kaballian/IC_ABAMP/forside.tex

\begin{center}
    \begin{figure}
        \centering
        
        \label{fig:logo}
    \end{figure}

\vspace*{1cm}
\huge  
\textbf{\hrulefill \\ EIC \\ \hrulefill}
\Large
\textbf{\\ Integrerede kredsløb}
\vspace{0.5cm}

\LARGE
%\textbf{Aarhus Universitet\\}
\vspace{0.7cm}
\resizebox{17cm}{!}{
\begin{tabular}{lllc}
     \multicolumn{4}{c}{IC Project - class AB Amplifier}\\
     \\
     \textbf{Navn} & \textbf{Initialer} & \textbf{Studienummer} & \textbf{Retning}\\
     \toprule
        Jakob Bjerregaard Olsen& JBO & 202109022 & E\\
        Alexander Nygaard Thomsen & AT & 201911329 & E\\

    \toprule
\textbf{Underviser: Jamaac Hassan Hire}  \\
\toprule
\\
    Afleveringsdato: 28/12/2025 \\
\end{tabular}
}
\end{center}
\newpage
