kaballian/IC_ABAMP/assignment_projectAB.pdf

# EIC

## Integrerede kredsløb

## IC Project - class AB Amplifier

Navn | Initialer Studienummer Retning
Jakob Bjerregaard Olsen | JBO | 202109022 | E
Alexander Nygaard Thomsen | AT | 201911329 | E

## Underviser: Jamaac Hassan Hire

## Afleveringsdato: 28/12/2025

## 1 introduction

The purpose of this project is to design and implement a Class AB audio power Amplifier, with some general requirements.
From the provided requirements of the project, the below states specifications are:
| Output power - This specification is a free choice and will be expanded later
| Input Resistance - >= 10kΩ
| Output Resistance - < 5Ω
| Bandwidth - bandwidth is specified to be in the human hearing range 20Hz - 20KHz
| Design Structure - must be based on a three stage topology, differential pre-amp, voltage amp stage and power amp stage.

From these given, overall requirements, our derived specifications are:

| Output power - Pout = 200mW
| load size - Giver the output power, the chosen load size is Rload = 16Ω
| Supply contrains - given power requirements and load size, the supply rails of the Amplifier system is ±15V

From our on own requirements, it is possible to derive some other specifications about the system. The output voltage/current RMS

VoutRMS =

p
Pout · Rload | (1)

IoutRMS =

r
Pout

Rload

(2)

We assume an input signal of VinRMS = 20mV , this gives an overall gain of

Vout

Vin

≈ 126 | (3)

To limit the Amplifier to the human hearing range, an lowpass filter is added to limit frequency content above 20KHz

fC = 20KHz | (4)
C = 470µF | (5)

XC =

1
2πf · C
= 0.017Ω | (6)

## 2 Input stage

The first part of the amplifier is the input stage, this specific implementation is build around a pair of NPN transistors. This particular implementation includes a tail current source, more specifcally a current mirror build as a sink.

### 2.1 topology

### 2.1.1 differential pair

Q4 and Q5 is an NPN differential pair, with R3 and R2 as collector loads and R15 and R16 as emitter degeneration resistors. This create a single-ended output differential amplifier. The emitter resistances are included to negate the temperature dependence of BJT’s and to make the transistor have a more linear behavior. This however changes how the transistors transconductance is calculated from gm =

IC
VT

to gm ≈

1
RE

, if and only if gmRE ≫ 1.

DC analysis


It is assumed that the BC547 has an beta factor of β = 325 and we aim for a diff amp gain of roughly Adif f ≈ 42. The current sink in bottom tries to draw 4mA of current, thus IEcm = 2mA must run in each branch of the Amplifier. The collector resistance then becomes

VCcm = VCC − RCcm · IEcmα ⇒ RCcm =

VCC − VCcm

IEcmα

= 7.774kΩ | (7)

AC analysis
For AC analysis, the intrinsic emitter resistance is re =

VT
2mA = 12.5Ω and the external emitter resistance is RE = 75Ω this yields a total emitter resistance of retot = 12.5Ω + 75Ω = 87.5Ω. Thus changes to temperature only affects the term with VT , which is ≈ ±2mV /C
The goal here is to relate the differential input voltage Vd to the output voltage Vo, by elimintating the internal transistor current ib, this will yield the gain. Since the desired gain for this Amplifier is chosen, we can use this to find the emitter resistance, which stated earlier is RE = 75Ω.

Since the other input of the differential amplifier is grounded, the differential voltage for Q4 becomes:

vIndif f
2
= ibrπ + ieRE | (8)
rπ = βre | (9)
ie = (β + 1)ib | (10)
⇓ | (11)
vd = 2ib(βre + (β + 1)RE) | (12)

And the common mode voltage then becomes:

vOutdif f = −β · ibcm · RCcm | (13)

These two defines the differential gain:

Adif f =

vOutdif f vIndif f
= −
βRC 2(βre + (β + 1)RE) | (14)

Since the gain has already been chosen in the design stage, as mentioned ealier, Adif f ≈ 42. The emitter resistance can be calculated, by solving for RE:

Adif f → RE ≈ 75Ω | (15)

It should be noted that the expression for the differential gain gets rather lengthy when expanded, thus for gains much larger than β ≫ 1, the 1 term in (β + 1), can safely be ignored. This factors out β in both numerator and denominator:

2(βre + (β + 1)RE) ⇒≈ β(re + RE) | (16)

Adif f ≈ −

RC
2(re + RE)
≈ −42.726 | (17)

It is desirable to know the common mode rejections ratio, and in order to find that, the common mode gain is needed. The common mode gain is given by the common mode input voltage over the common mode output voltage. But in order to express them the value of REE needs to be known. REE is placed to reduce the stress on the transistor in the current mirror. An assumption of the collector emitter voltage being 0.3V is made to ensure that the transistor is operating in the active region. Based on this assumsion the expression for REE is given by

0V − VBE − RE · IE − 2 · IE · REE − VCE − VEE = 0V | (18)

REE =

VBE − RE · IE − VCE − VEE
2 · IE
= 3.838kΩ ≈ 3.9kΩ | (19)

Now the common mode input voltage can be expressed as:

vInCM = ib · (β + 1) · re + ib · (β + 1) · RE + 2 · ib · (β + 1) · REE | (20)

The times 2 comes from the fact that know there is a contribution from both branches. The output common mode is given by:

vOutCM = −β · ib · RC | (21)

With the two above equations the common mode gain can be expressed as:

ACM =

vOutCM

vInCM

=

−β · ib · RC
ib · (β + 1) · re + ib · (β + 1) · RE + 2 · ib · (β + 1) | (22)

In the above equation ib can be removed because it is multiplied on both the denominator and numerator. Then by combining common expressions in the denominator then the gain can be expressed as:

ACM =

−β · ib · RC
(β + 1) · (re + RE + 2 · REE)
= −0.948 | (23)

Now that both the differential and common mode gain is known the common mode rejection ration can be calculated. It is given as:

CMRR = 20 · log(Adif f
ACM
) = 33.078dB | (24)

### 2.2 Current Sink

The pupose of the current mirror is to supply, or in this case ”sink” the required current for the differential amplifier. This means that it should be specified to draw the sum of the currents leaving both branches of the diff amp. Thus the equations becomes:

ICQ6 = IEEcm = 4mA | (25)
(26)

Because it is a BC547 again, the same β = 325 is assumed, this means that current entering the base of Q6.

IBQ6 =

ICQ6
β
≈ 12µA | (27)

(28)

Since the current mirror is comprised to two NPN transistors, the current drawn should be the sum of the collector current ICQ5 and 2 base currents.

IRCQ5 = 2IBQ6 + ICQ5 = 4.025mA | (29)

Therefore the resistance to define the reference current becomes:

Rref =

VCC − VEE

IRCQ5

≈ 7.5kΩ | (30)

## 3 Voltage Amplification Stage

Following the differential amplifier is a Voltage amplification stage. The purpose of this circuit is to gain the signal.


Figure 1: voltage amplification stage

The design goal of this stage is a gain of 3. And to realize this goal a few other contraints are chosen to make it easier, such as the emitter current should be IE = 5mA and VCE = 7.5V , to ensure in the active region.

From these contrains the ratio of the emitter and collector resistor can be determined. Also note that this the current design is for DC, thus for the AC gain an additional impedance can be coupled in to reduce the emitter resistance in AC and increase the gain.

iB =

vin

RIN

vo = −RC ibβ | (31)

subtituting

vo = −RC

vin

RIN

β ⇒ −α

RC
RE

(32)

Setting RC = 3kΩ, means that, at AC, RE = 1kΩ
To achieve the current at DC, the emitter resistance can be calculated:

REdc =

VCC − RC IEα − V CE − VEE
IE
≈ 1.5kΩ | (33)

To compensate for this in AC, an impedance consisting of a resistance and a capacitor is set in parallel with the emitter resistance. This essentially shapes the gain when an AC input is given.

ANdc =

R8
R9
= 2 | (34)

ANac =

R8
R9||R28
| = 3 | (35)

This happends when when the corner frequency of:

fc =

1
2πR28C6

=

1
2π · 3kΩ · 47nF
| ≈ 1.13Hz | (36)

is exceeded.
Other parameters for the stage:
VC = VCC − RC IEα = 0.046V | (37)
VE = IERE + VEE = −7.5V | (38)
VB = VE + VBE = −6.8V | (39)

IB =

IE
(β + 1) ≈ 15.3µA | (40)

Biasing the stage then comes from a collector base resistor

RC B =

15V − (−6.8V )
15.3µA | = 1.425MΩ | (41)

## 4 Unity gain Buffer

To prevent loading of the voltage amplification stage into the output stage, a unity gain buffer is implemented to increase the perceived impedance, the output of the voltage amplification stage sees. This is implemented as a common collector amplifier with a gain of ≈ 1.

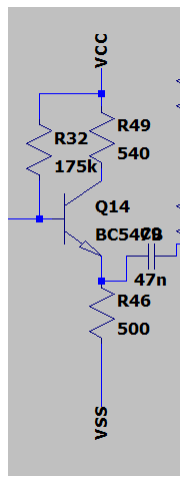
[picture p10: figure]

Figure 2: common collector unity gain buffer

To ensure that the buffer has low output impedance, so it does not affect the circuitry that comes after, a decently sized standing current is necessary. To drive the stage a ratherl large emitter current of 28mA is chosen.

VE = VSS + IER46 = −1V | (42)
VB = VB + 0.7V = −0.3V | (43)

IB =

IE
β + 1
≈ 85µA | (44)

The biasing resistor then becomes:

R32 =

VSS − VB
IB
≈ 178kΩ | (45)

The collector current then becomes:

IC =

β
β + 1
IE ≈ 27.9mA | (46)

and to sanity check if the current is possible the voltage across the collector and emitter must be above 0.3V

VC = V cc − IC R49 = −0.074V | (47)
VCE = VC − VE = 0.926V | (48)

This shows that the unity gain buffer can drive this configuration. The small signal parameters becomes:

re ≈

VT
IE

=

25mV
28mA = 0.893Ω | (49)
rπ = βre ≈ 290Ω | (50)

Output impedance, when looking into the emitter. The sources becomes AC ground, this means that the output impedance becomes

Rout ≈ re||500Ω ≈ re | (51)

## 5 Output Stage

The output stage consists mainly of circuitry to handle the final power amplification of the amplification, the purpose is to gain the currents and not the voltage signal. Because this is a Class AB, this means that two output transistors are driving each half of the signal cycle, however to change this from class B to AB, it requires transistor biasing, so that cross distortion is avoided.


Figure 3: Output stage, everything to the right of the red line, is considered part of the output stage.

To bias the two output transistors, a Vbe multiplier has been implemented. Q15 and the two resistors R37/38 generate a controlled voltage, which is used to determine the working point of the output follow the expression:

Vbias ≈ VbeQ15 · (1 + R37
R38
) ≈ 2VBE | (52)

This then becomes a scale factor for the transistors base emitter voltage, meaning that the collector voltage will sit an additional drop above it, of ≈ 1.4V Practically this circuit also provides the ability to thermally track or follow the output transistors, due the possibility to physically mount the circuit thermally close to the output.

The biasing part of the stage is driven by a current sink similar to the one found in the input stage, however this sinks 3mA of current. This means that the voltages at the output stages are.

VR47 = 3mA · 4.8kΩ = 14.4V | (53)
VBm3 = 0.6V | (54)
VR42 = 3mA · 4.5kΩ = 13.5V | (55)
VBm4 = −15V + 13.5V = −1.5V | (56)

Quiescent current through the output stage can then be expressed as:

IQ ≈

Vbias − (VBE,N + |VBE,P |)
R43 + R44

(57)

This indicates that the output stage is somewhat sensitive to changes in changes in both transistors Vbe due to fact that those resistances, R43 + R44 are so small.

The two emitter resistors linearize the transfer characteritics of the output transistors and limits thermal runaway. The main purpose of those transistors, is to turn small changes in Vbe into current chnages, therefore the small signal voltage gain is AN ≈ 1. The output impedance, can be approximated by

Rout ≈

re
β + 1
+ R43 + R44 | (58)

Where re ≈

VT
IE

### 5.1 Simulation

Using the calculated values from the analysis, the circuit was then simulated in LTspice. The complete circuit can be seen below. Using the .tren spice directive to test the circuit and checking for behavior.


Figure 4: Complete circuit in LTspice.

Grounding both of the inputs and probing the simulation model, resulted in a measurement of 1.468V at the collector of Q4 and having its emitter sit a diode drop below ground, means that this transistor is in the active region.

At Dc the current sink through R27 is around 3.6mA.

As for the voltage amplification stage, the collector sits at 0.56V and the emitter at -7.76V, this means that this coupling also is in the active region. With an emitter current of roughly 4.8mA

In the output stage, the current drawn thought the vbe multiplier is roughly 2.94mA, which is close to the desired 3mA. The lower bias point sits at ≈ −474mV , while the upper bias point is at ≈ 842mV , this means that there is approximately a multiple of 2 base emitter voltage difference between the two points, which is intended.

Lastly the Quiescent current, at DC, running through R42 is 1.92mA. This current is flowing to load, as it seems to be strongly tied to ground. There is only 30mV at the collector of M4, so the Vbe of M4 is not high enough to draw the current at this stage.


Figure 5: RMS current measurement at the output of the amplification, more specifically the current running in the load

With a RMS current of IOUT = 95.832mA running in the 16Ω load, the power can be calculated:

VOUT = IRMS · RLOAD = 95.832mA · 16Ω = 1.5328VRMS | (59)
POUT = IRMS · VOUT = 0.146W | (60)

This simulated power is a little lower than intended.

### 5.2 Realization

The circuit was the built and realized. The realized circuit can be seen on figure 6. The circuit was tested the same way the simulation was, the settinges for the signal used can be seen on figure 7

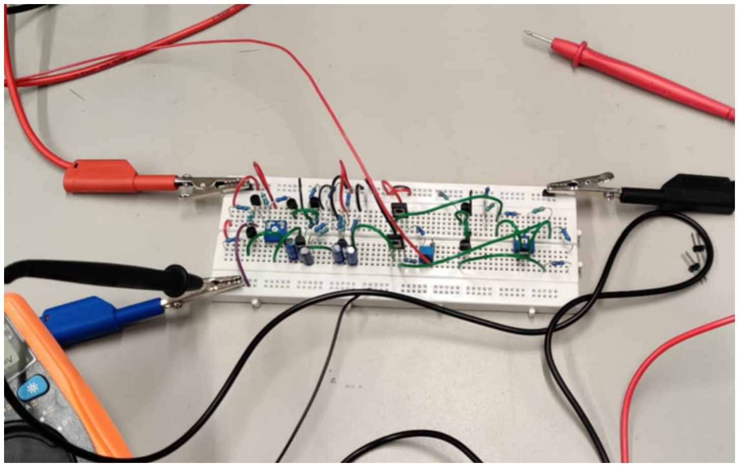
[picture p11: figure]

Figure 6: implementation on breadboard


Figure 7: The chosen input signal is a pure signe wave with a 20mV amplitude at 10kHz

Table 1: Measured DC voltages of bias points in amplifier circuit

Class AB DC points | Diff sig[V] | Diff No sig[V] | CE amp[V] | C amp[V] | AB NPN[V] | AB NPN[V]
V C | 1.83 | 2.18 | -0.15 | 0.88 | 15 | -15.01
V E | -0.644 | -0.645 | -6.75 | -0.82 | -0.76 | -0.28
V B | 0 | 0 | -5.6 | -0.16 | 0.44 | -1.02

On figure 8 the amplification results can be seen for after the common mode amplifier and the commen emitter amplifer(voltage amplification stage). The final gain for the amplifier is somewhat lower than expected. On table 1 the DC point for the diffrent transistors is shown, here it can be seen that the DC points are the with in resenable range and they are in the active region


Figure 8: Measurements of the amplifier. The orange trace is from after the differential amplifier, to show much the signal is gained. The blue trace is from the output of the amplifier itself.

## 6 conclusion

It can then be concluded that the audio amplifier works as intended and that it mostly satisfies our requirements, set in the specification. However, we fell short of the gain goal of ≈= 126, we achieved ≈ 87, the measured signal peak of the output was

VoutP eak = 1.749V | (61)

VoutRMS =

1.749V
√
2
= 1.236VRMS | (62)

Whereas the input rms is roughly VinRMS = 0.014V this leads to a input to output ratio of

Vout

Vin

=

1.236V
0.014
≈ 87.45 | (63)

As for power, the output current becomes 1.236
16Ω = 77.25mARMS which results in 1.749V · 77.25mA = 95.53mW of power being drawn, this is also not close our target of 200.
