kaballian/IC_ABAMP/Class AB AMP.pdf

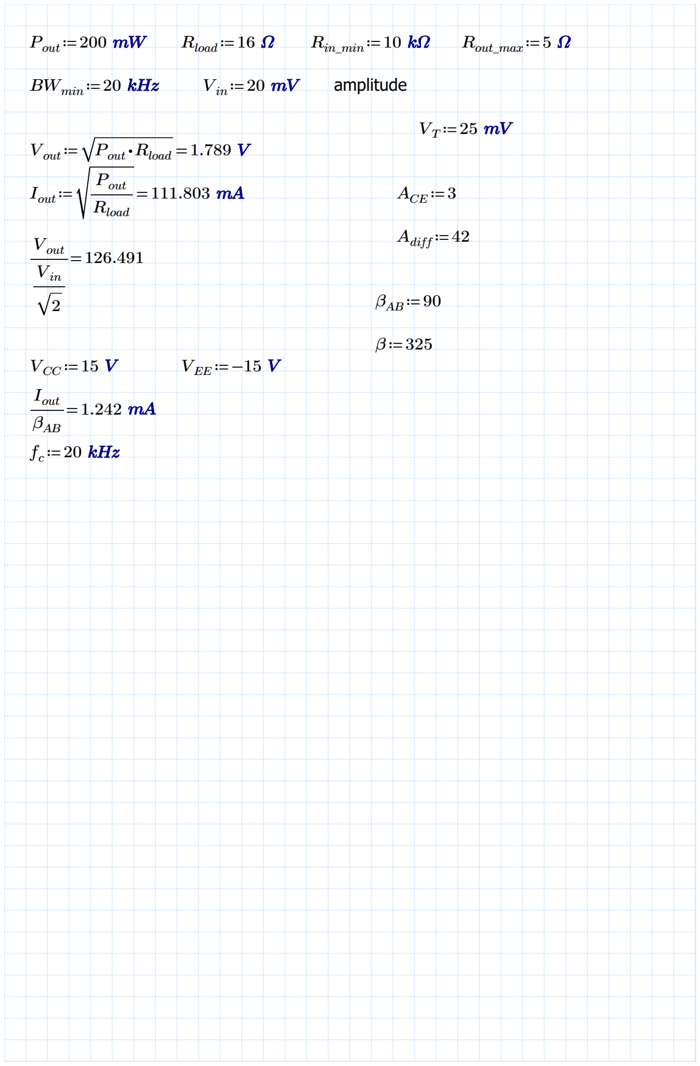
[picture p12: figure]
Pout≔200; Rload≔16 Ω; Rin_min≔10 kΩ; Rout_max≔5 Ω; BWmin≔20 kHz; Vin≔20; amplitude; Vout≔; Pout⋅Rload=1.789 V; Iout≔; Pout; Rload; ACE≔3; Adiff≔42 ――= Vout; Vin; βAB≔90; VCC≔15 V; VEE≔-15; Iout; βAB; fc≔20 kHz

Non-Commercial Use Only

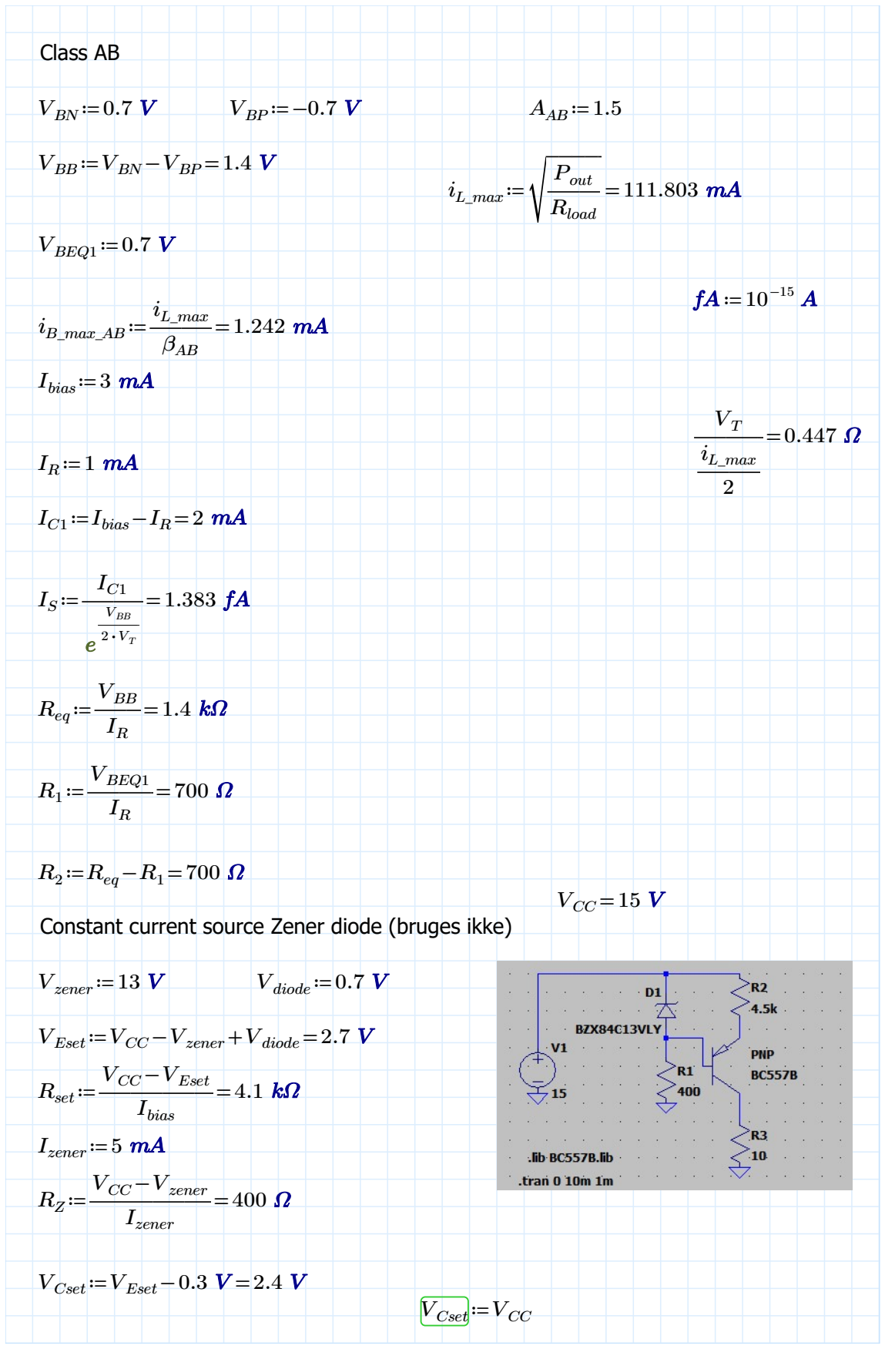
[picture p13: figure]
Class AB; VBN≔0.7 V; VBP≔-0.7 V; AAB≔1.5; VBB≔VBN -VBP=1.4; iL_max≔; Pout; Rload; VBEQ1≔0.7 V; iB_max_AB≔――=; iL_max; βAB; Ibias≔3; iL_max 2; IC1≔Ibias-IR =2 mA; VBB 2 ⋅ VT; Req≔――=; VBB IR; VBEQ1 IR; R2≔Req-R1=700; VCC =15 V; Vzener≔13; Vdiode≔0.7 V; VEset≔VCC -Vzener+Vdiode=2.7 V; Rset≔――――=; VCC -VEset; Ibias; Izener≔5 mA; VCC -Vzener; Izener; VCset≔VEset-0.3 V =2.4 V; VCset≔VCC

Constant current source Zener diode (bruges ikke)

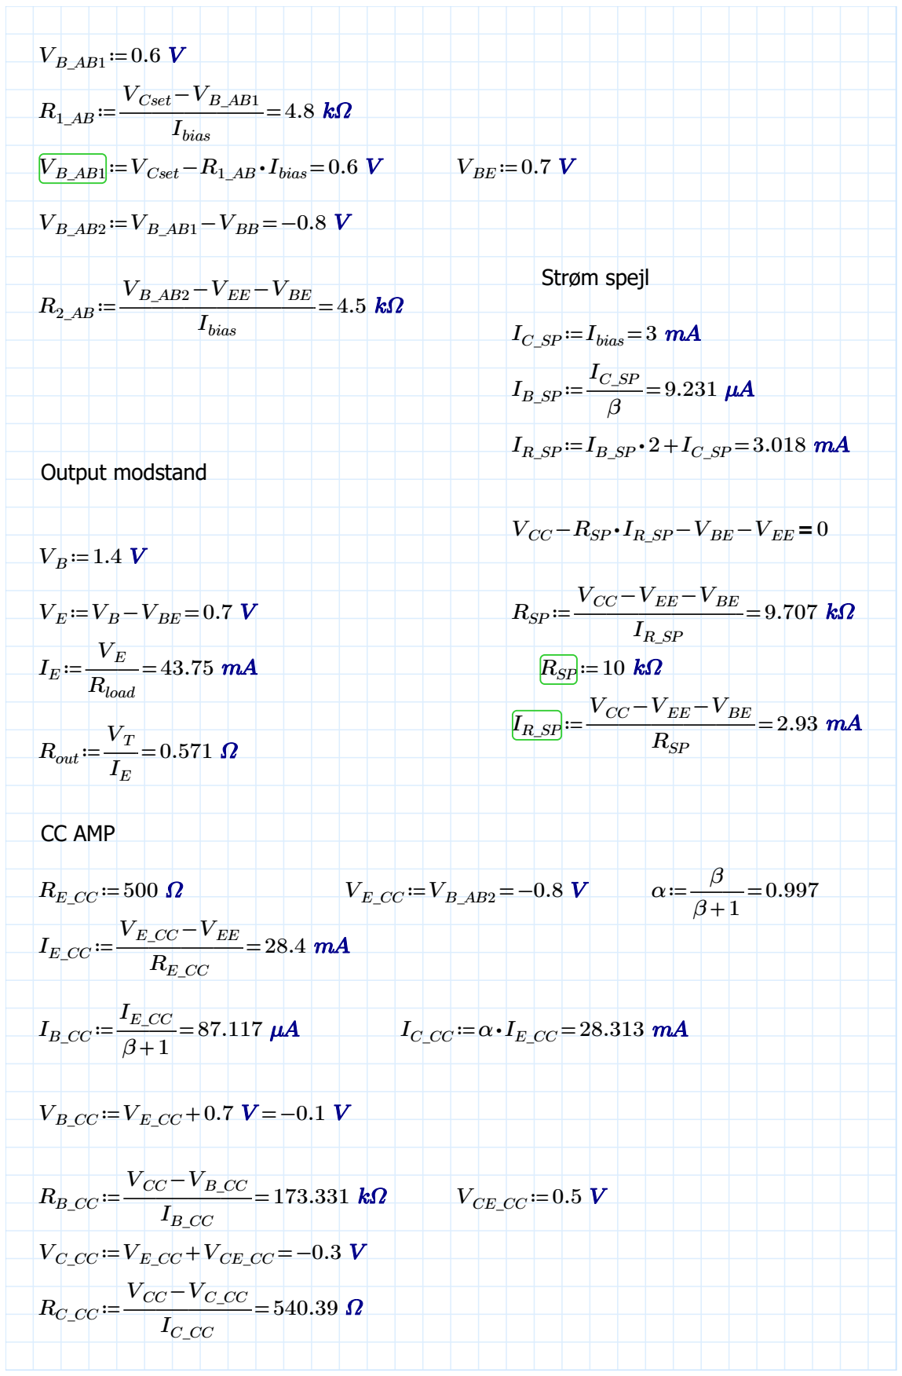
[picture p14: figure]
VCset-VB_AB1; Ibias; VB_AB1≔VCset-R1_AB ⋅ Ibias=0.6; VBE≔0.7 V; VB_AB2≔VB_AB1-VBB =-0.8 V; Strøm spejl; VB_AB2-VEE -VBE; Output modstand; IC_SP≔Ibias=3 mA; VE≔VB -VBE =0.7 V; Rload; VCC -RSP ⋅ IR_SP-VBE -VEE＝0; Rout≔――=; RSP≔――――――=; VCC -VEE -VBE; RSP≔10 kΩ; RSP; CC AMP; VE_CC -VEE; VCC -VB_CC; VCE_CC≔0.5; VC_CC≔VE_CC +VCE_CC =-0.3 V; VCC -VC_CC

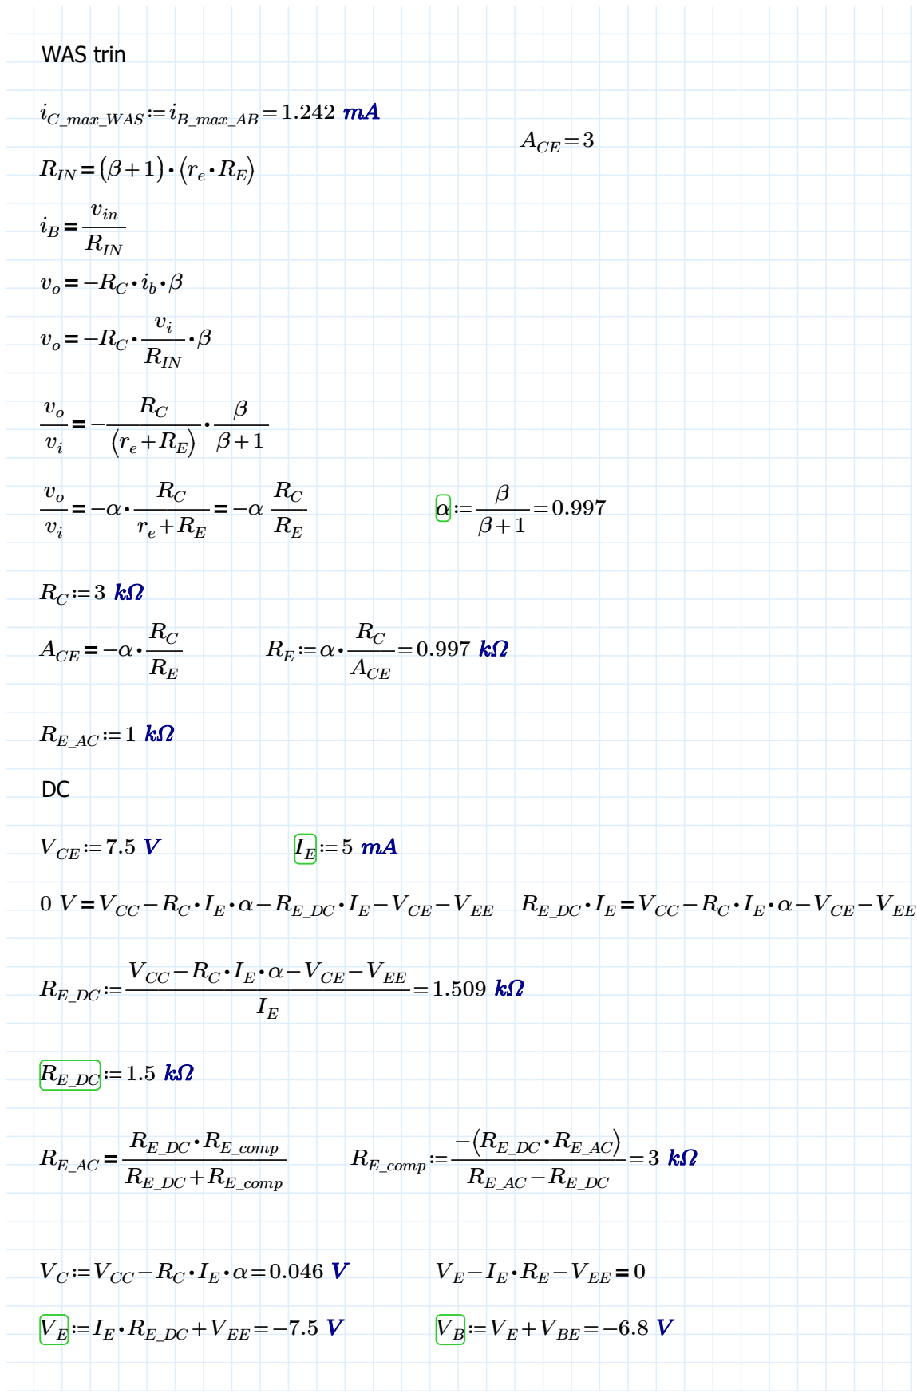
[picture p15: figure]
WAS trin; iC_max_WAS≔iB_max_AB =1.242 mA; ACE =3; RIN＝((β+1)) ⋅ ⎛⎝r; vin; RIN; ACE＝-α⋅――; ACE; VCE≔7.5 V; VCC -RC ⋅ IE ⋅α-VCE -VEE IE; RE_DC ⋅RE_comp; RE_DC +RE_comp; RE_comp≔――――――=; VE≔IE ⋅RE_DC +VEE =-7.5; VB≔VE +VBE =-6.8

0 | V＝VCC -RC ⋅ IE ⋅α-RE_DC ⋅ IE -VCE -VEE | RE_DC ⋅ IE＝VCC -RC ⋅ IE ⋅α-VCE -VEE
VC≔VCC -RC ⋅ IE ⋅α=0.046 V | VE -IE ⋅RE -VEE＝0

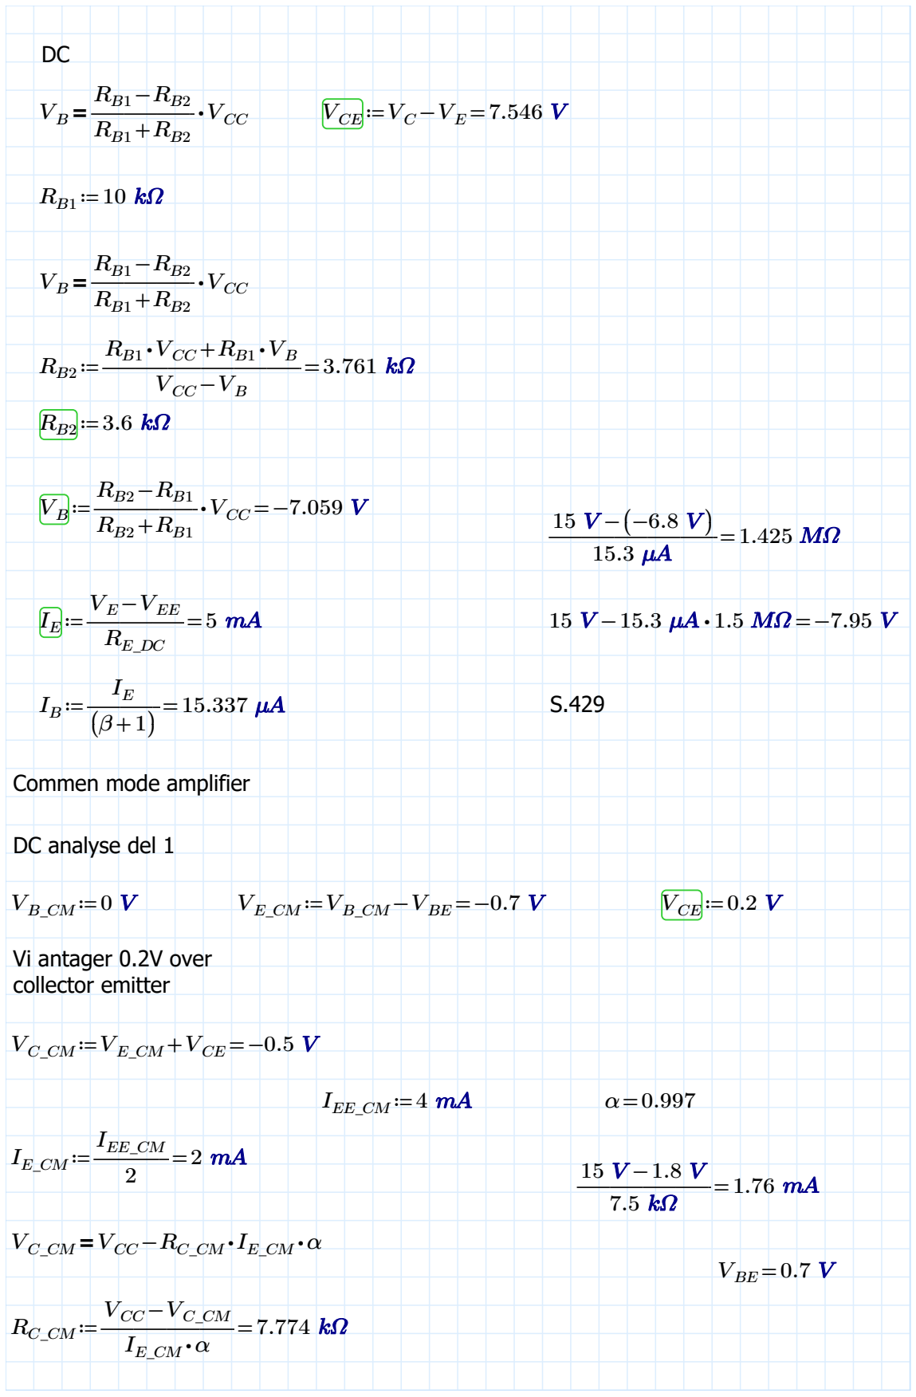
[picture p16: figure]
VCC; VCE≔VC -VE =7.546; RB1 ⋅VCC +RB1 ⋅VB VCC -VB; VE -VEE; Commen mode amplifier; DC analyse del 1; VE_CM ≔VB_CM -VBE =-0.7 V; VCE≔0.2 V; Vi antager 0.2V over collector emitter; VC_CM ≔VE_CM +VCE =-0.5 V; IEE_CM ≔4; IEE_CM 2; VC_CM＝VCC -RC_CM ⋅ IE_CM ⋅α; VBE =0.7 V; VCC -VC_CM

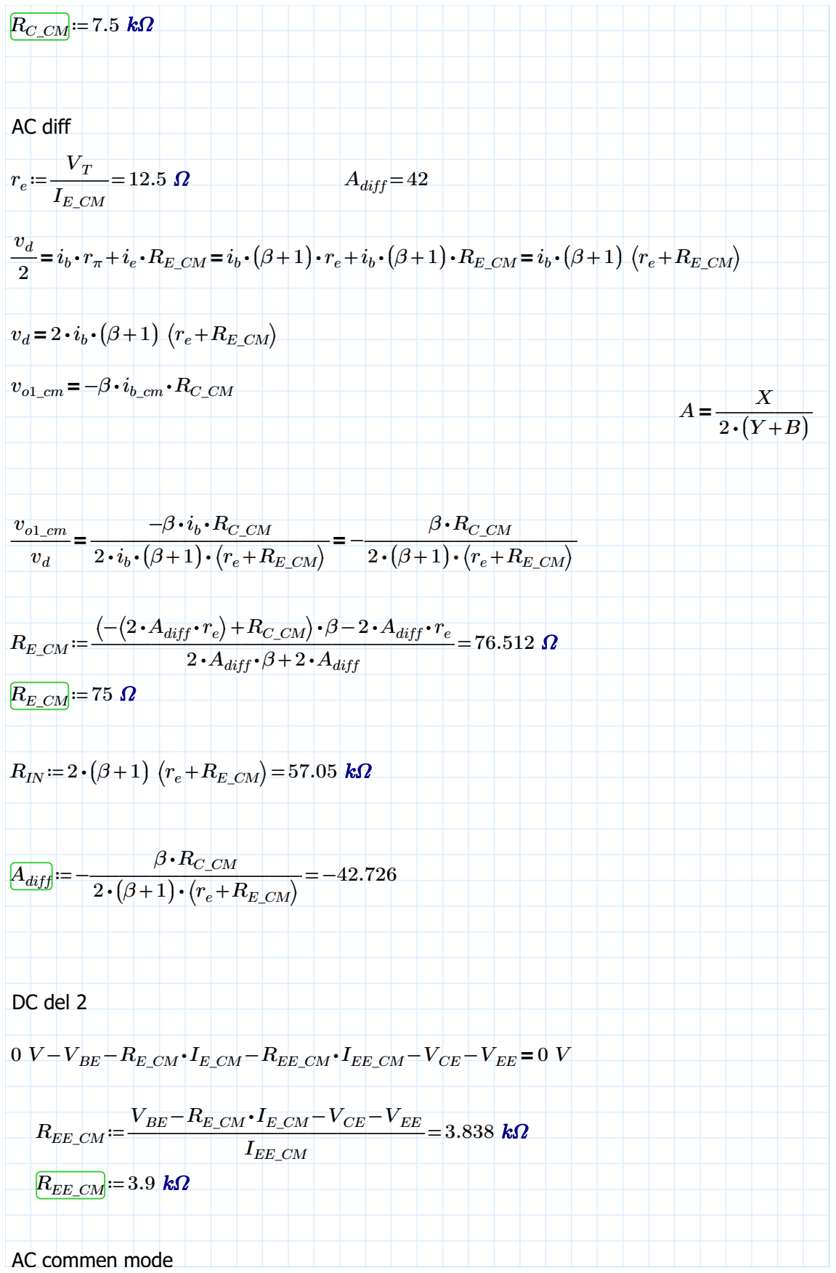
[picture p17: figure]
AC diff; Adiff=42; ⎛⎝-⎛⎝2 ⋅Adiff ⋅ re; ⋅ diff re; 2 ⋅Adiff ⋅β+2 ⋅Adiff; RIN≔2 ⋅ ((β+1)) ⎛⎝re+RE_CM⎞; Adiff≔-――――――――=; DC del 2; REE_CM ≔――――――――――=; VBE -RE_CM ⋅ IE_CM -VCE -VEE; IEE_CM; REE_CM ≔3.9; AC commen mode

### 0 V-VBE -RE_CM ⋅ IE_CM -REE_CM ⋅ IEE_CM -VCE -VEE＝0 V

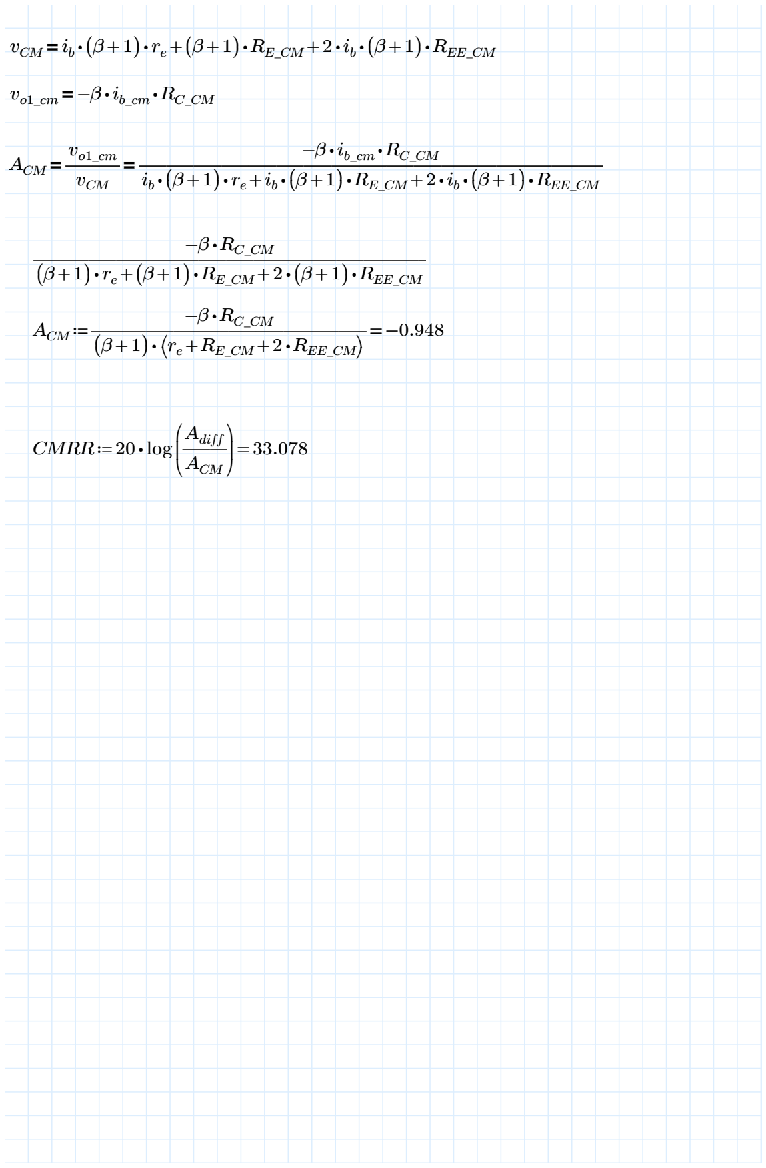
[picture p18: figure]
vCM＝ib; REE_CM; ACM＝――＝; vCM; ACM ≔―――――――――――=; -β⋅RC_CM ((β+1)) ⋅ ⎛⎝re+RE_CM +2 ⋅REE_CM⎞ ⎠; CMRR≔20 ⋅log; Adiff; ACM

⋅ ((β+1)) ⋅ re+((β+1)) ⋅RE_CM +2 ⋅i | ⋅ | ⋅ b

((β+1)) ⋅ re+((β+1)) ⋅RE_CM +2 ⋅ ((β+1)) ⋅REE_CM

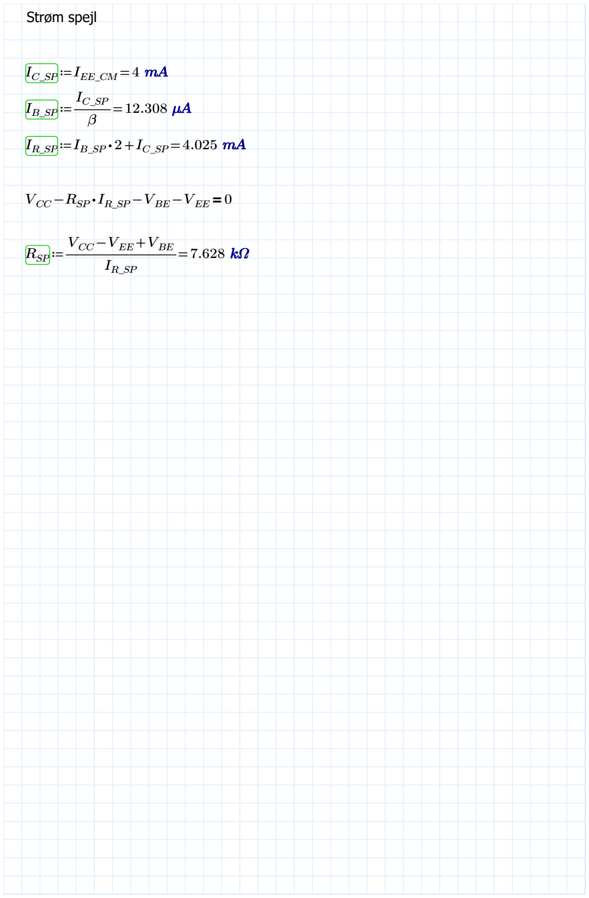
[picture p19: figure]
Strøm spejl; IC_SP≔IEE_CM =4 mA; VCC -RSP ⋅ IR_SP-VBE -VEE＝0; RSP≔――――――=; VCC -VEE +VBE
