kaballian/IC_ABAMP/power_amp.png

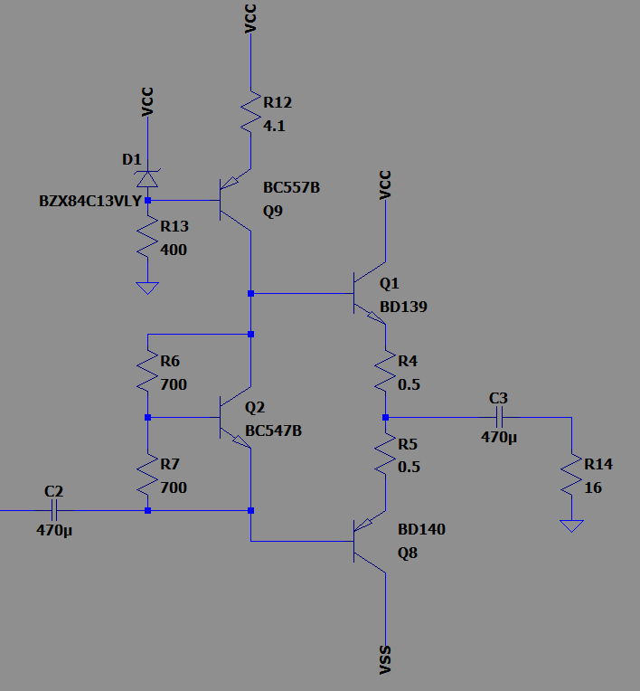
power_amp.png
