kaballian/IC_ABAMP/zener_source.png

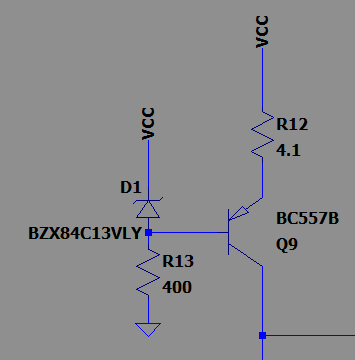
zener_source.png
