kaballian/IC_ABAMP/measurements/AB amp.ods

Class AB DC points | Diff Sig [V] | Diff No sig | CE Amp | CC Amp | AB NPN | AB PNP
V_C | 1,83 | 2,18 | -0,15 | 0,88 | 15 | -15,01
V_E | -0,644 | -0,645 | -6,75 | -0,82 | -0,76 | -0,28
V_B | 0 | 0 | -5,6 | -0,16 | 0,44 | -1,02
