kaballian/IC_ABAMP/AudioAmp.asc

C1: cap; 47n
C2: cap; 47n
C3: cap; 47µ
C4: cap; 47µ
C5: cap; 47µ
C6: cap; 47n
C7: cap; 47µ
C9: cap; 47n
D1: zener; BZX84C13VLY
D2: diode; 1N4148
D3: diode; 1N4148
D4: zener; BZX84C13VLY
D5: zener; BZX84C13VLY
L3: ind; 1m
L4: ind; 1m
M1: nmos; BD139
M2: pmos; BD140
M3: nmos; BD139
M4: pmos; BD140
Q1: npn; BC547B
Q2: npn; BC547B
Q3: npn; BC547B
Q4: npn; BC547B
Q5: npn; BC547B
Q6: npn; BC547B
Q7: npn; BC547B
Q8: npn; BC547B
Q9: pnp; BC557B
Q10: npn; BC547B
Q11: npn; BC547B
Q12: npn; BC547B
Q13: pnp; BC557B
Q14: npn; BC547B
Q15: npn; BC547B
Q16: pnp; BC557B
Q17: npn; BC547B
Q18: npn; BC547B
R1: res; 7.5k
R2: res; 7.5K
R3: res; 7.5K
R4: res; 1
R5: res; 1
R6: res; 650
R7: res; 650
R8: res; 3k
R9: res; 1.5k
R10: res; 1.425Meg
R11: res; 4.7Meg
R12: res; 4.1k
R13: res; 390
R14: res; 16
R15: res; 75
R16: res; 75
R17: res; 7.628k
R18: res; 7.5k
R19: res; 7.5k
R20: res; 75
R21: res; 75
R22: res; 3.9k
R23: res; 3k
R24: res; 3k
R25: res; 10k
R26: res; 3.6k
R27: res; 3.9K
R28: res; 3k
R29: res; 1.425Meg
R30: res; 1.5k
R31: res; 600
R32: res; 175k
R33: res; 4.1k
R34: res; 390
R35: res; 600
R36: res; 4.7k
R37: res; 650
R38: res; 650
R39: res; 4.1k
R40: res; 400
R41: res; 600
R42: res; 4.5k
R43: res; 1
R44: res; 1
R45: res; 16
R46: res; 500
R47: res; 4.8k
R48: res; 10k
R49: res; 540
V1: voltage; 15
V2: voltage; -15
V3: voltage; SINE(0 20m 10k)
Named nets: 0, VCC, VSS, Sig
.lib BC557B.lib
.lib BC547B.lib
.lib BD139.lib
.lib BD140.lib
.tran 0 10m 0.1m
