kaballian/IC_ABAMP/Zener.asc

BC557B: pnp
D1: zener; BZX84C13VLY
R1: res; 400
R2: res; 4.5k
R3: res; 10
V1: voltage; 15
Named nets: 0
.lib BC557B.lib
.tran 0 10m 1m
