kaballian/IC_ABAMP/(commit log)

2025-12-14 progress into VAS stage, some design specs needs to be revised
2025-12-27 update design and included measurements
    [AB amp.ods, AB_AMP.csv]
2025-12-27 writing power stage
2025-12-27 somewhat done with report
    [AB_AMP.csv]
